TheLastGimbus/KWPUE-Projekt/pcb-print.jpg

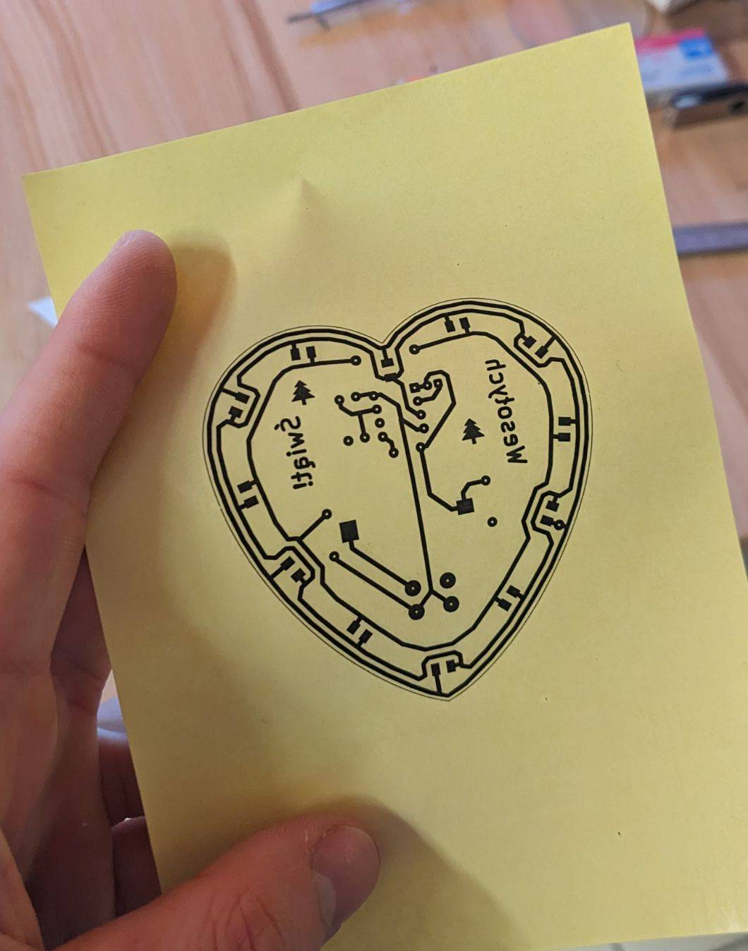
pcb-print.jpg
