TheLastGimbus/KWPUE-Projekt/pcb-before-etch.jpg

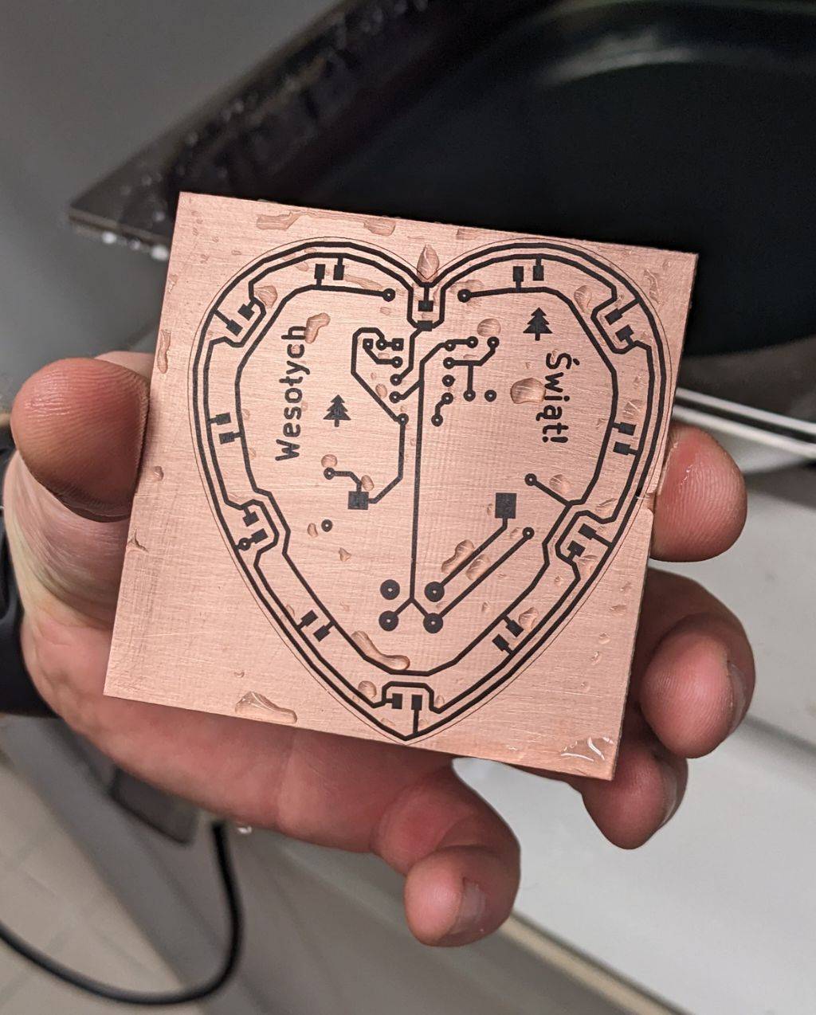
pcb-before-etch.jpg
