TheLastGimbus/KWPUE-Projekt/KWPUTE-prezentacja-Mateusz_Soszynski-282935.pdf

Komputerowe wspomaganie projektowania układów elektronicznych

## Projekt własny - mrugające serce 🩵

Mateusz Soszyński, 282935
Grupa 3 (czwartek 12:30 - 14:45) 15.01.2026

### Spis treści

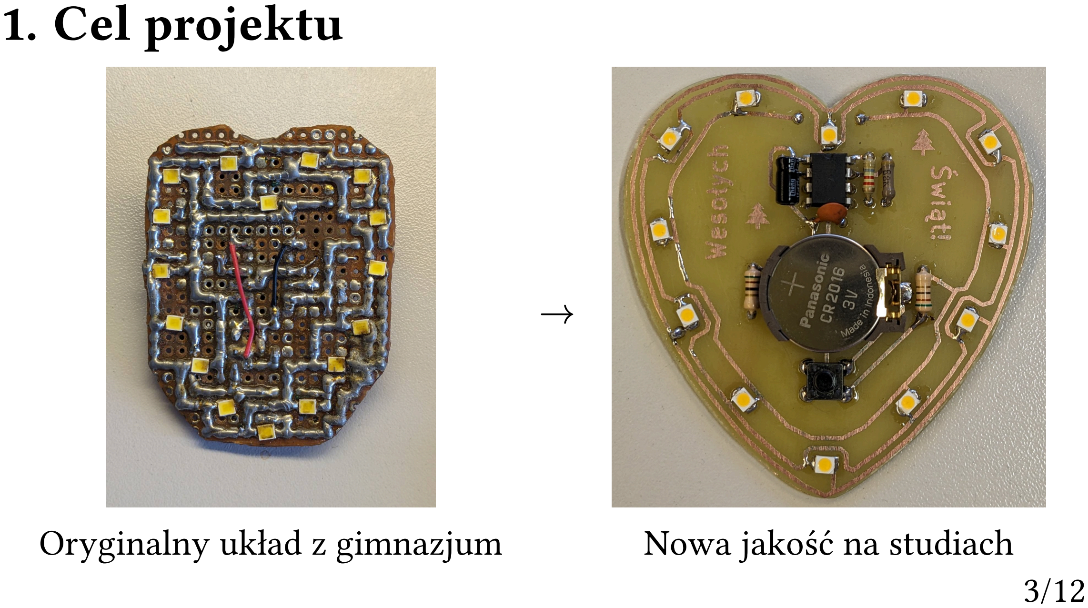
[picture p3: page 3]

### 1. Cel projektu

Oryginalny układ z gimnazjum

→

Nowa jakość na studiach

### 2. Zasada działania

NE555 w trybie astabilnym:

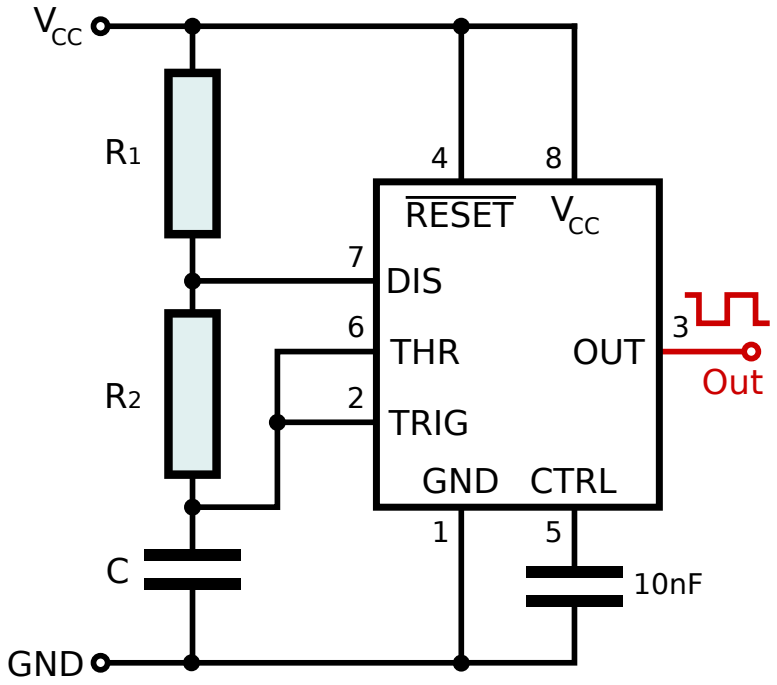
[picture p4: figure]
GND; RESET; OUT; TRIG; CTRL; VCC; DIS; THR; Out R2
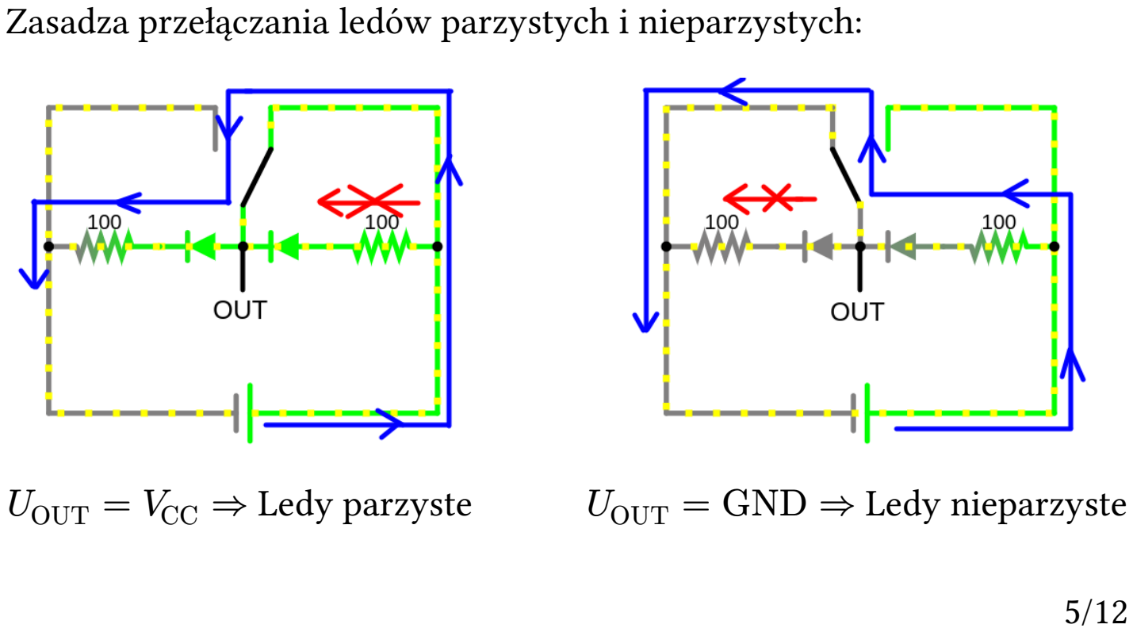
[picture p5: page 5]

Zasadza przełączania ledów parzystych i nieparzystych:

UOUT = VCC ⇒ Ledy parzyste UOUT = GND ⇒ Ledy nieparzyste

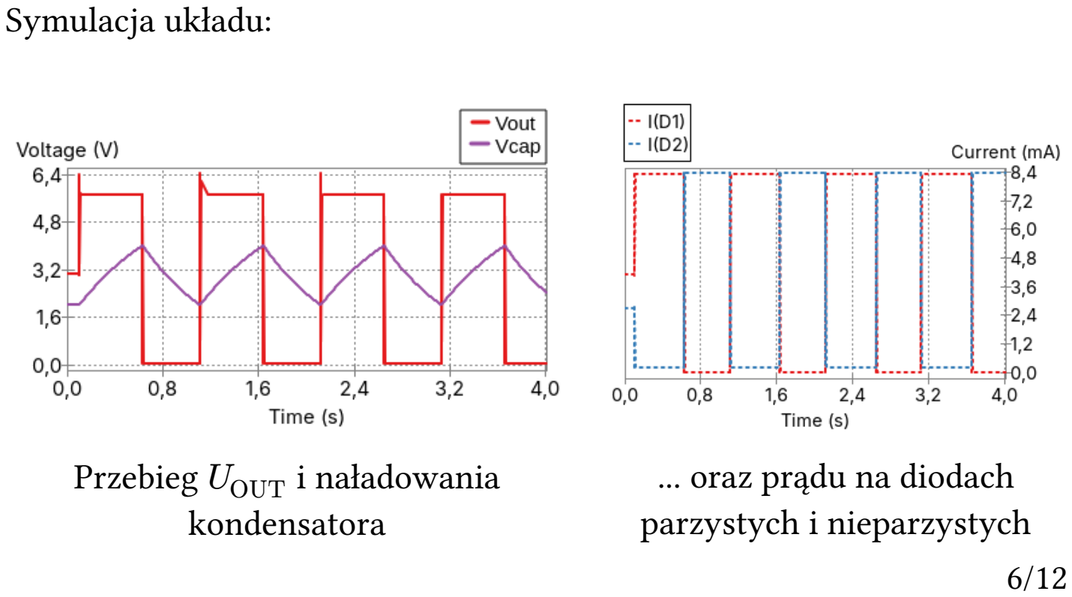
[picture p6: page 6]

Symulacja układu:

Przebieg UOUT i naładowania kondensatora

... oraz prądu na diodach
parzystych i nieparzystych

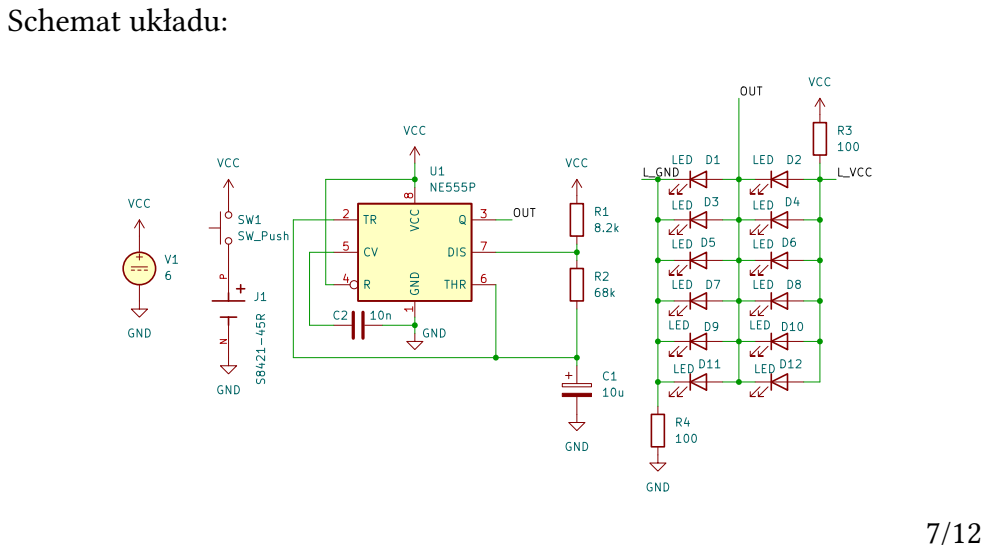
[picture p7: page 7]
Schemat układu:

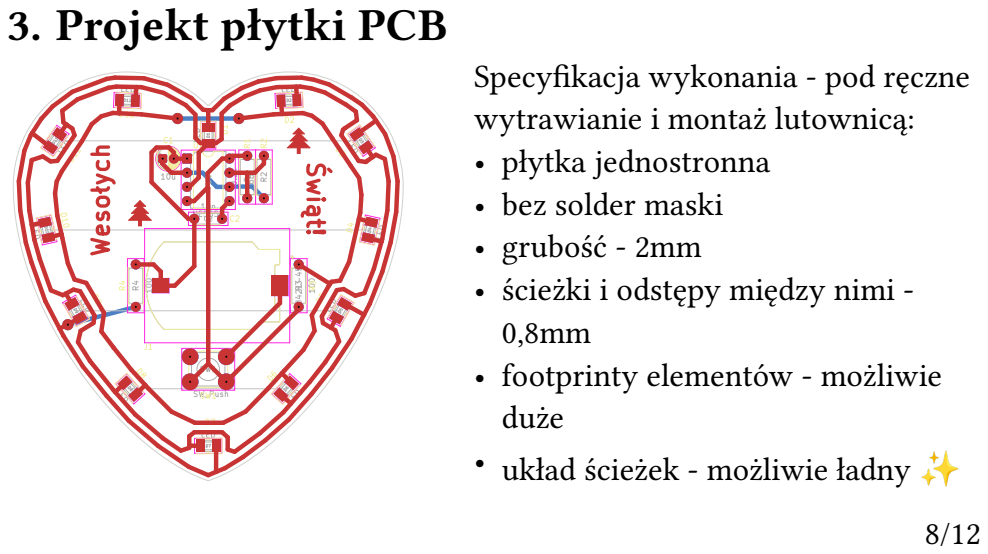
[picture p8: page 8]

3. Projekt płytki PCB

Specyfikacja wykonania - pod ręczne
wytrawianie i montaż lutownicą:
• płytka jednostronna
• bez solder maski
• grubość - 2mm
• ścieżki i odstępy między nimi -
• footprinty elementów - możliwie
duże
• układ ścieżek - możliwie ładny ✨

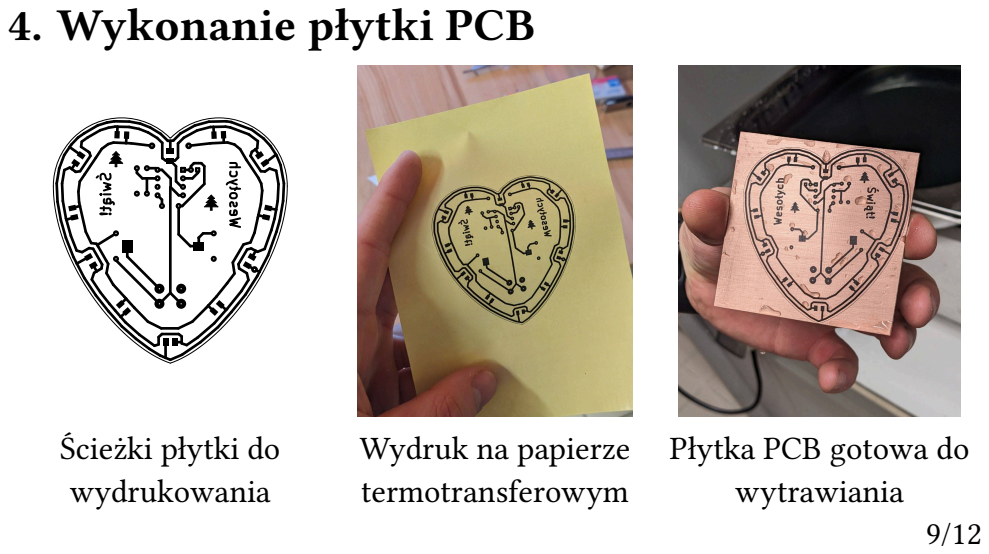
[picture p9: page 9]

4. Wykonanie płytki PCB

Ścieżki płytki do
wydrukowania

Wydruk na papierze
termotransferowym

Płytka PCB gotowa do
wytrawiania

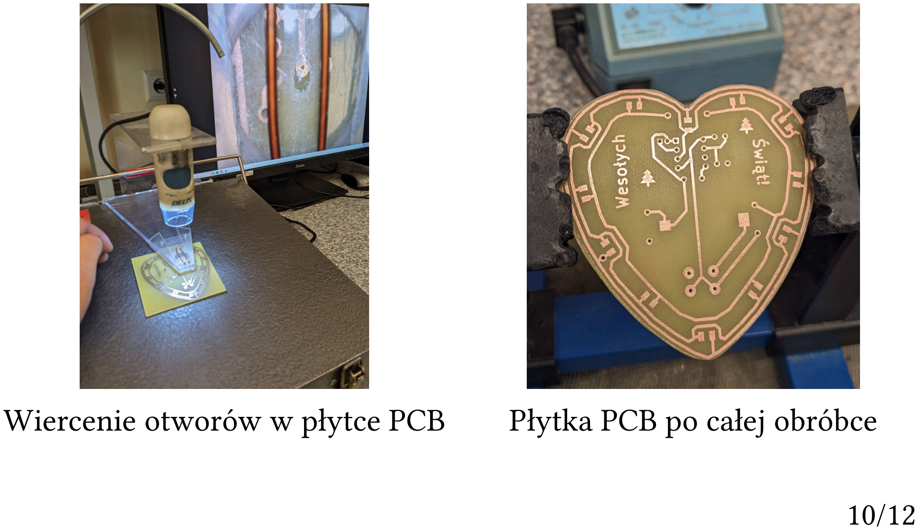
[picture p10: page 10]

Wiercenie otworów w płytce PCB Płytka PCB po całej obróbce

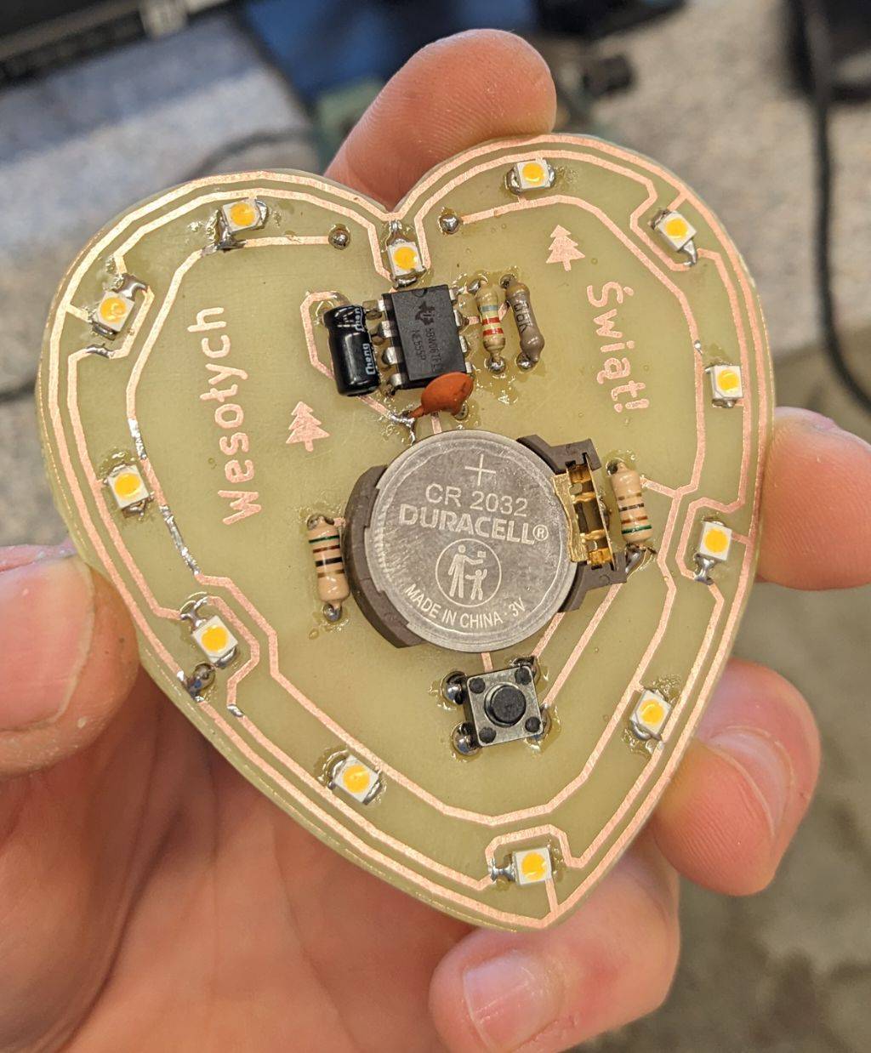
[picture p11: figure]

Złożony układ | 11/12

# Dziękuje za uwage 🩵
