TheLastGimbus/KWPUE-Projekt/falstad-l.png

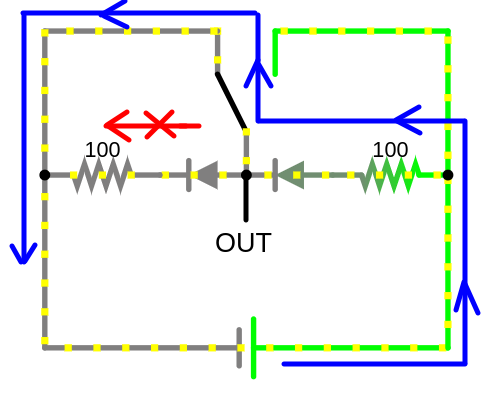
falstad-l.png
