TheLastGimbus/KWPUE-Projekt/sim-d.png

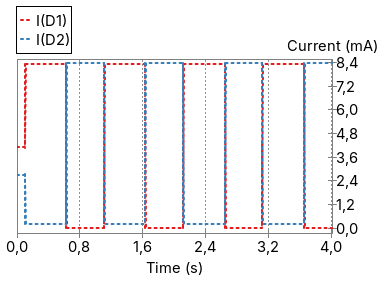
sim-d.png
