TheLastGimbus/KWPUE-Projekt/sim.png

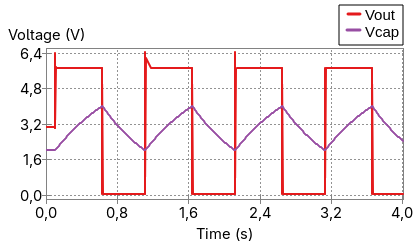
sim.png
