TheLastGimbus/KWPUE-Projekt/projekt1.asc

C1: cap; 10µ
C2: cap; 10n
D1: LED
D2: LED
D3: LED
D4: LED
D5: LED
D6: LED
R1: EuropeanResistor; 8k2; tol=100k
R2: EuropeanResistor; 68k
R3: EuropeanResistor; 500
R4: EuropeanResistor; 500
U1: NE555
V1: voltage; 5
Named nets: 0, Vcc, NEout
.tran 10s startup
