TheLastGimbus/KWPUE-Projekt/projekt/projekt.kicad_pcb

## KiCad design projekt/projekt.kicad_pcb (2025-12-18)

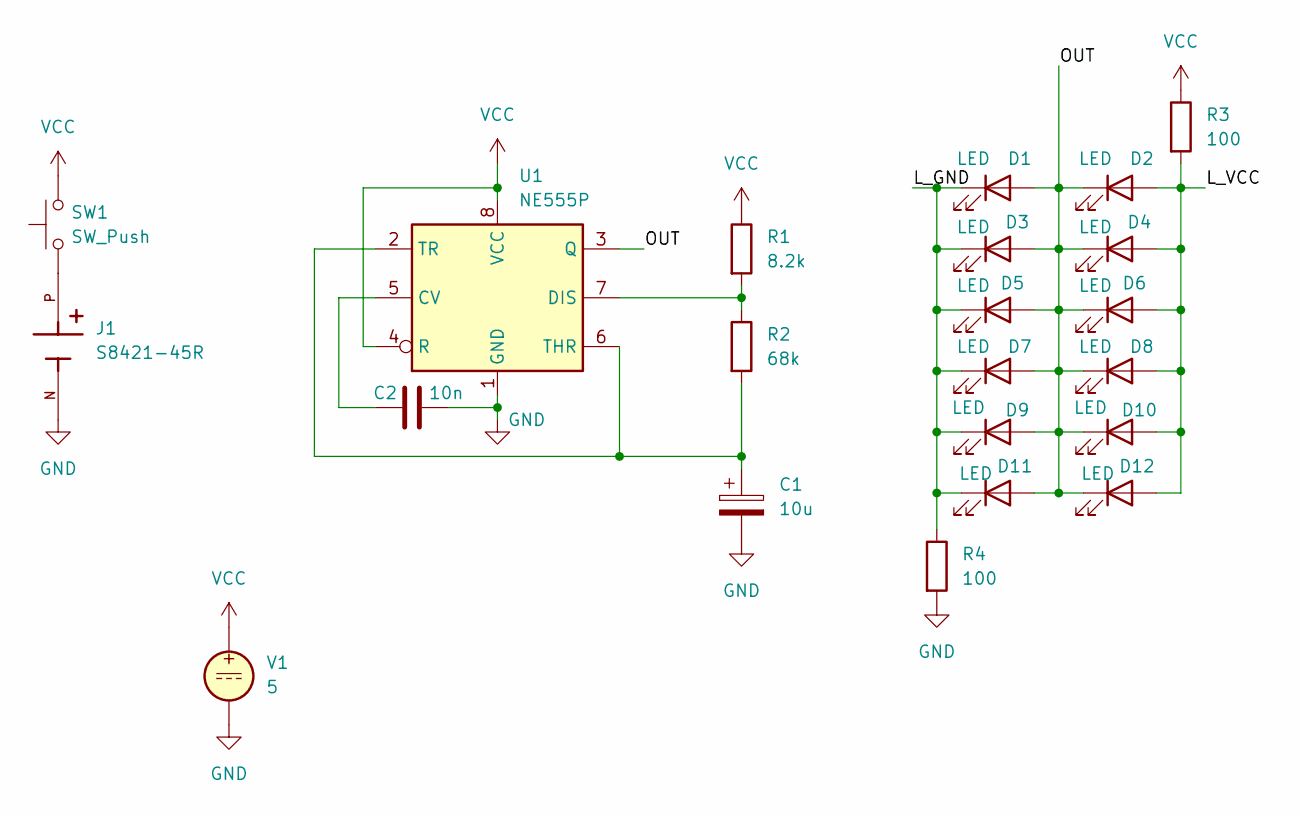
[picture p27: schematic projekt.kicad_sch]

Parts:
C1: 10u; CP_Radial_D4.0mm_P2.00mm
C2: 10n; C_Disc_D4.3mm_W1.9mm_P5.00mm
D1, D2, D3, D4, D5, D6, D7, D8, D9, D10, D11, D12: LED; LED_PLCC-2_3x2mm_KA
J1: S8421-45R; HARWIN_S8421-45R; PARTREV 7
R1: 8.2k; R_Axial_DIN0207_L6.3mm_D2.5mm_P7.62mm_Horizontal
R2: 68k; R_Axial_DIN0207_L6.3mm_D2.5mm_P7.62mm_Horizontal
R3, R4: 100; R_Axial_DIN0207_L6.3mm_D2.5mm_P7.62mm_Horizontal
SW1: SW_Push; SW_PUSH_6mm
U1: NE555P; DIP-8_W7.62mm
V1: 5

Connections:
/L_GND: D1.1 (K), D3.1 (K), D5.1 (K), D7.1 (K), D9.1 (K), D11.1 (K), R4.1
/L_VCC: D2.2 (A), D4.2 (A), D6.2 (A), D8.2 (A), D10.2 (A), D12.2 (A), R3.2
/OUT: D1.2 (A), D2.1 (K), D3.2 (A), D4.1 (K), D5.2 (A), D6.1 (K), D7.2 (A), D8.1 (K), D9.2 (A), D10.1 (K), D11.2 (A), D12.1 (K), U1.3 (Q)
GND: C1.2, C2.2, J1.N, R4.2, U1.1 (GND), V1.2
unnamed: J1.P, SW1.1
unnamed: C2.1, U1.5 (CV)
unnamed: R1.2, R2.1, U1.7 (DIS)
unnamed: C1.1, R2.2, U1.2 (TR), U1.6 (THR)
VCC: R1.1, R3.1, SW1.2, U1.4 (R), U1.8 (VCC), V1.1

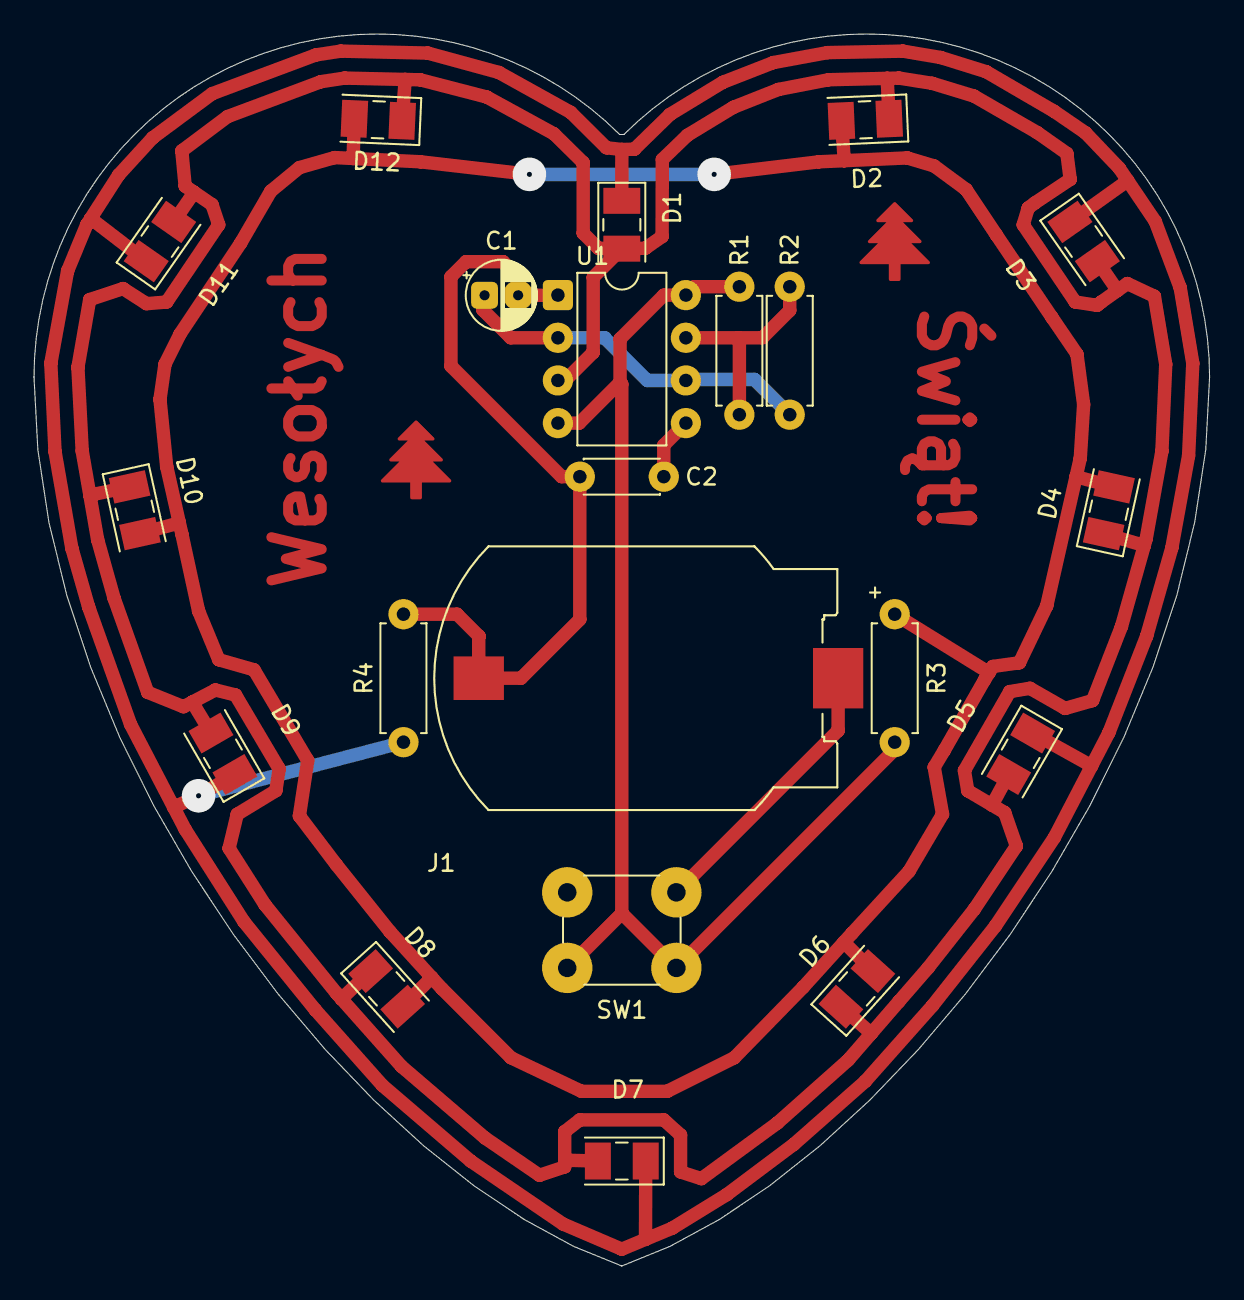
[picture p28: board projekt.kicad_pcb from above]

Board: 2 copper layers, 70.0 x 73.4 mm, 21 parts (0 on the bottom side), 9 nets.
