TheLastGimbus/KWPUE-Projekt/(commit log)

2025-12-09 ou jea
    [projekt.kicad_pcb, projekt.kicad_sch]
2025-12-09 cos sie zepsulo
    [projekt.kicad_pcb]
2025-12-09 make it kinda work
    [projekt.kicad_pcb, projekt.kicad_sch]
2025-12-09 wow! serduszko!
    [projekt.kicad_pcb, projekt.kicad_sch]
2025-12-13 serduszko nawet bardziej
    [projekt.kicad_pcb]
2025-12-13 wiekszy margines od kranca swiata
    [projekt.kicad_pcb, projekt.kicad_sch]
2025-12-13 ja pd udało sie - wszystkie połączenia zrobione
    [projekt.kicad_pcb]
2025-12-13 poprawione napisy
    [projekt.kicad_pcb]
2025-12-15 wieksze dziury
    [projekt.kicad_pcb]
2025-12-18 V3! grubsze wszystko!
    [projekt.kicad_pcb]
2026-01-11 zdjęcia i wgl
    [projekt.kicad_sch]
2026-01-14 poczatek prezentacji i poprawka sprawka
    [projekt.kicad_sch]
